acheng21567/RISCV-CPU-with-Image-Coproc-FPGA/RTL/coproc/VGA_test/Miku.bmp

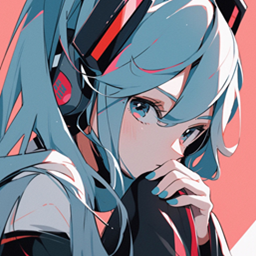
RTL/coproc/VGA_test/Miku.bmp
