acheng21567/RISCV-CPU-with-Image-Coproc-FPGA/Design_Diagrams/output_images/Contrast_Color_vs_Color.png

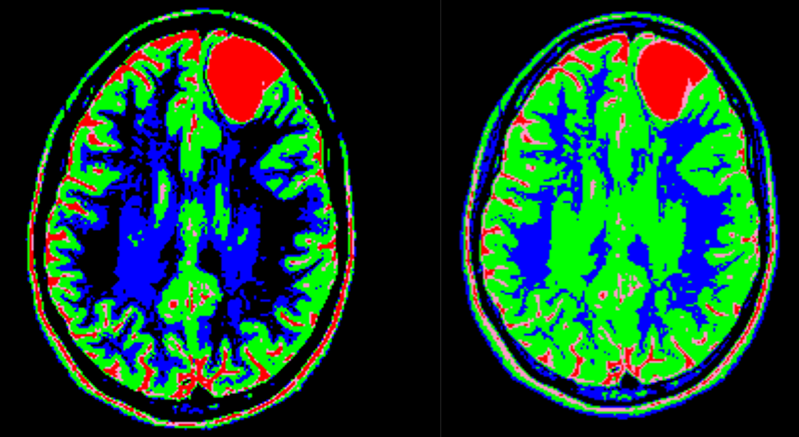
Design_Diagrams/output_images/Contrast_Color_vs_Color.png
