acheng21567/RISCV-CPU-with-Image-Coproc-FPGA/Design_Diagrams/Synthesis/top.pdf

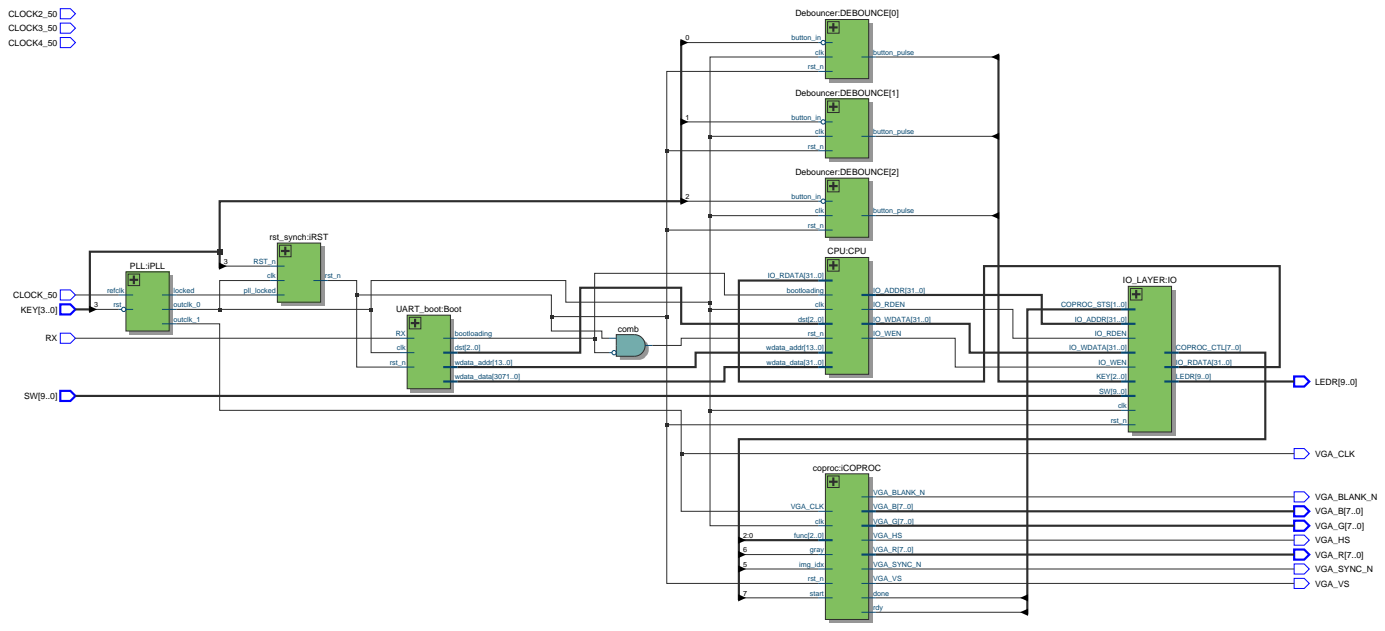
[picture p37: figure]
CLOCK_50 KEY[3..0]; PLL:iPLL; refclk; rst; locked; outclk_0; outclk_1; rst_synch:iRST; RST_n; clk; pll_locked; rst_n; UART_boot:Boot; bootloading; wdata_data[3071..0]; wdata_addr[13..0]; dst[2..0]; comb; Debouncer:DEBOUNCE[0]; button_in; button_pulse; Debouncer:DEBOUNCE[1]; Debouncer:DEBOUNCE[2]; CPU:CPU; IO_RDATA[31..0]; wdata_data[31..0]; IO_RDEN; IO_WEN; IO_WDATA[31..0]; IO_ADDR[31..0]; coproc:iCOPROC; VGA_CLK; gray; img_idx; start; func[2..0]; VGA_BLANK_N; VGA_HS; VGA_SYNC_N; VGA_VS; done; rdy; VGA_B[7..0]; VGA_G[7..0]; VGA_R[7..0]; IO_LAYER:IO; KEY[2..0]; COPROC_STS[1..0]; LEDR[9..0]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
