acheng21567/RISCV-CPU-with-Image-Coproc-FPGA/Bootload/pikachu.bmp

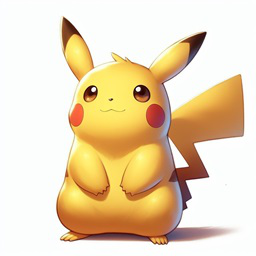
Bootload/pikachu.bmp
