acheng21567/RISCV-CPU-with-Image-Coproc-FPGA/COPROC/python/brain.bmp

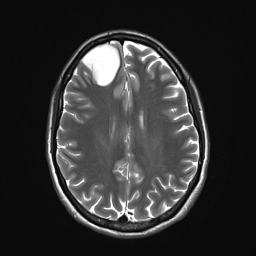
COPROC/python/brain.bmp
