acheng21567/RISCV-CPU-with-Image-Coproc-FPGA/COPROC/python/output_image.png

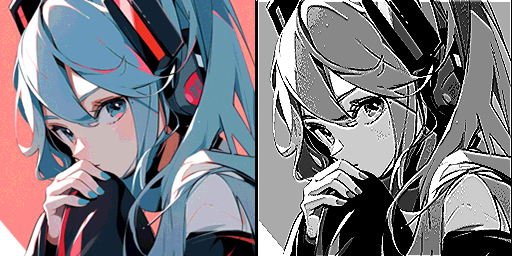
COPROC/python/output_image.png
