acheng21567/RISCV-CPU-with-Image-Coproc-FPGA/DEMO/Bootload/images/bunny.png

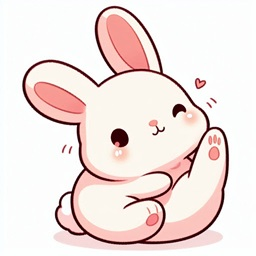
DEMO/Bootload/images/bunny.png
