acheng21567/RISCV-CPU-with-Image-Coproc-FPGA/Design_Diagrams/another_output_images/output_image_contrast.png

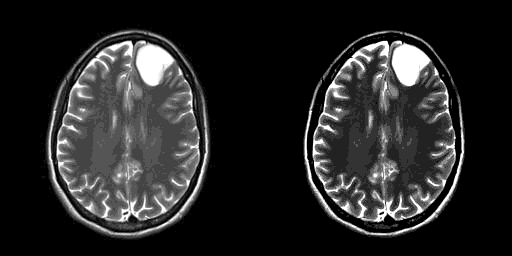
Design_Diagrams/another_output_images/output_image_contrast.png
