acheng21567/RISCV-CPU-with-Image-Coproc-FPGA/Design_Diagrams/Bootload.png

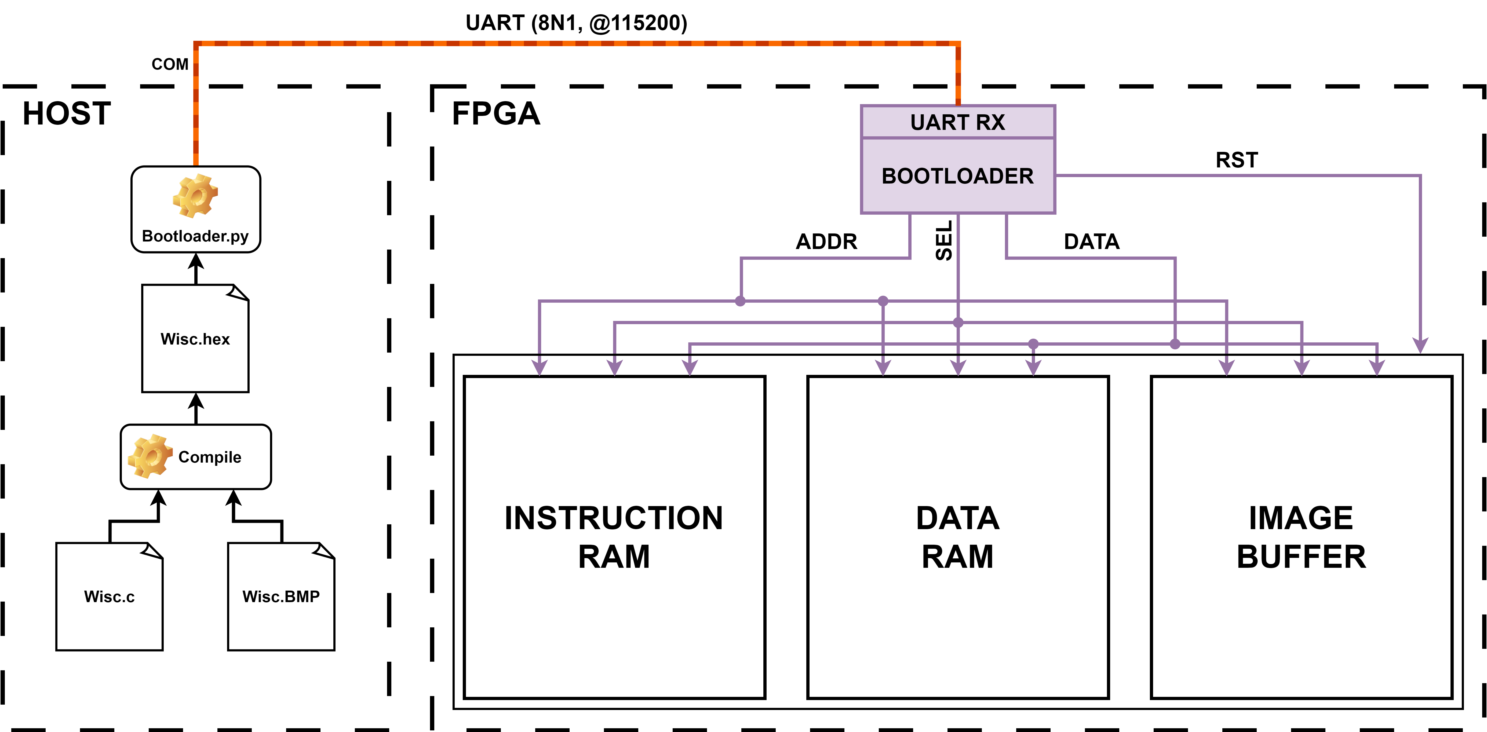
Design_Diagrams/Bootload.png
