acheng21567/RISCV-CPU-with-Image-Coproc-FPGA/Design_Diagrams/bootload_top-Copy of Page-1.png

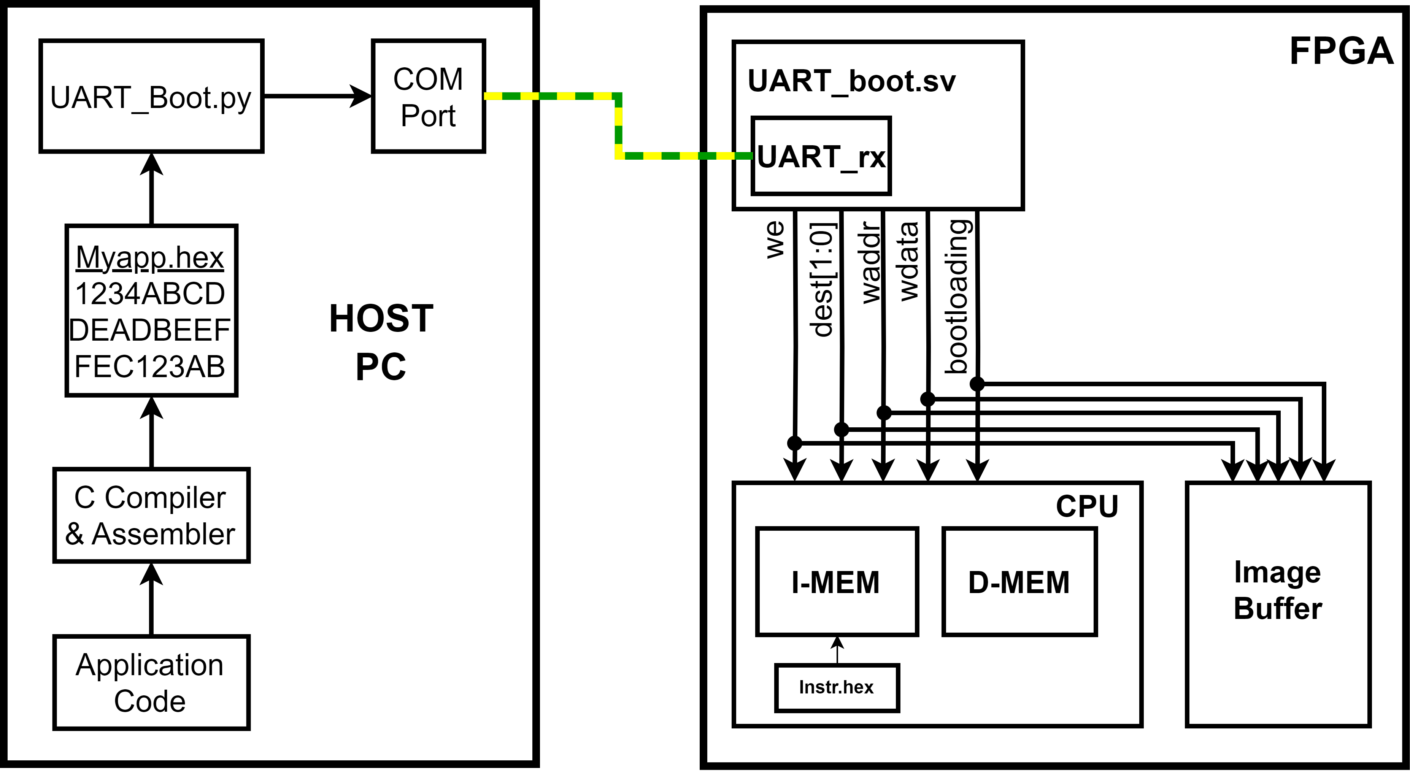
Design_Diagrams/bootload_top-Copy of Page-1.png
