acheng21567/RISCV-CPU-with-Image-Coproc-FPGA/Design_Diagrams/COPROC-FUNC.png

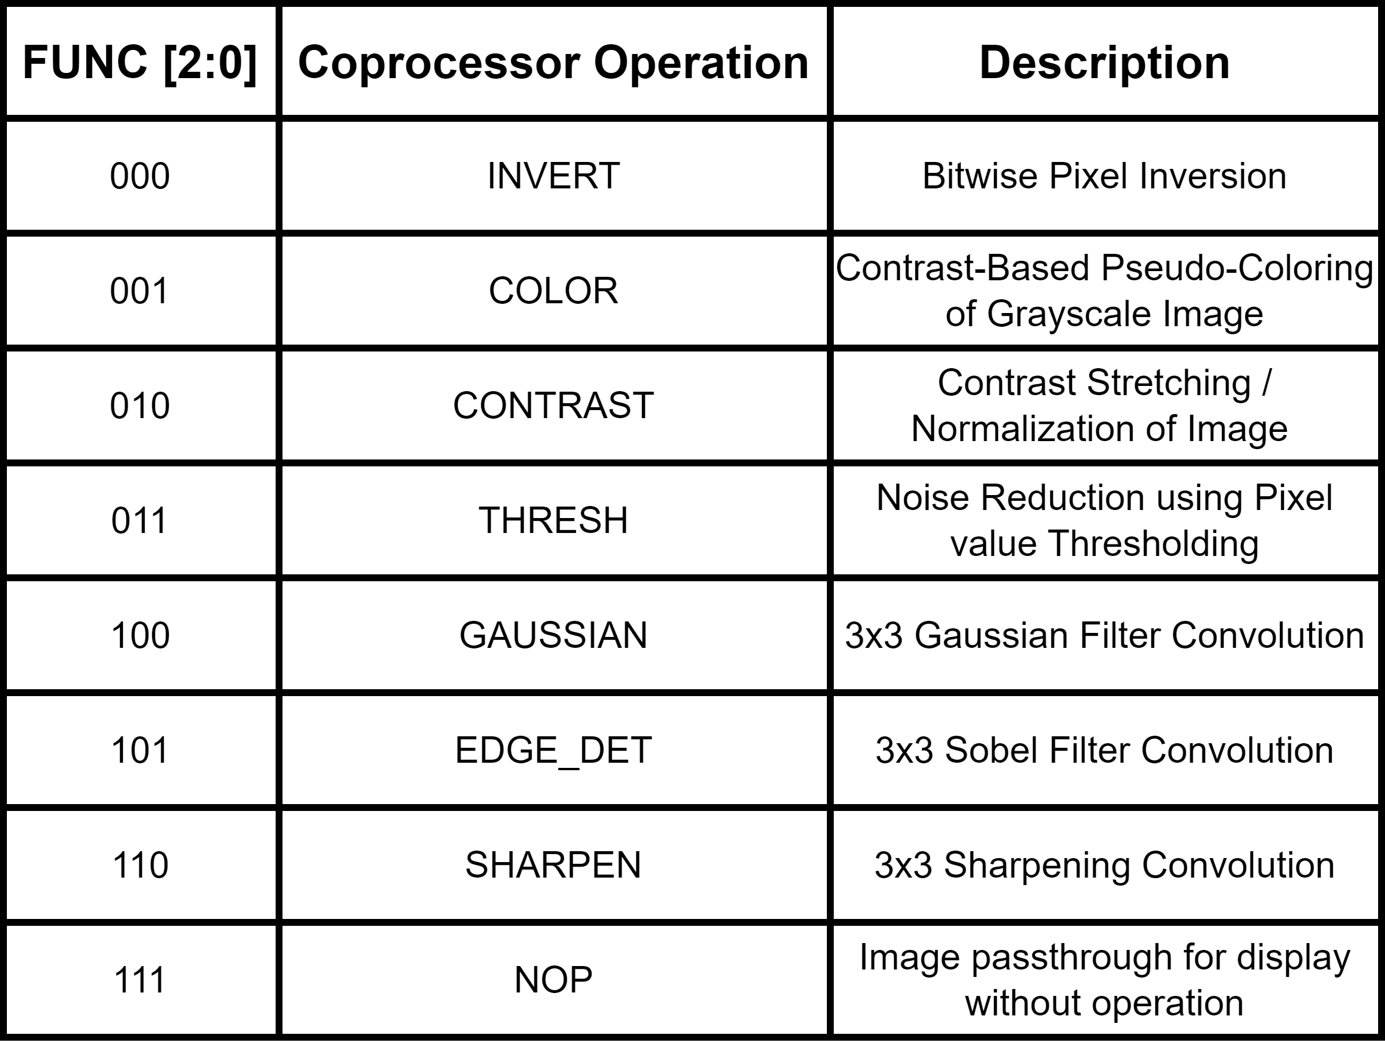
Design_Diagrams/COPROC-FUNC.png
