acheng21567/RISCV-CPU-with-Image-Coproc-FPGA/Design_Diagrams/DESIGN_DIAGRAMS-BOOTLOADER.png

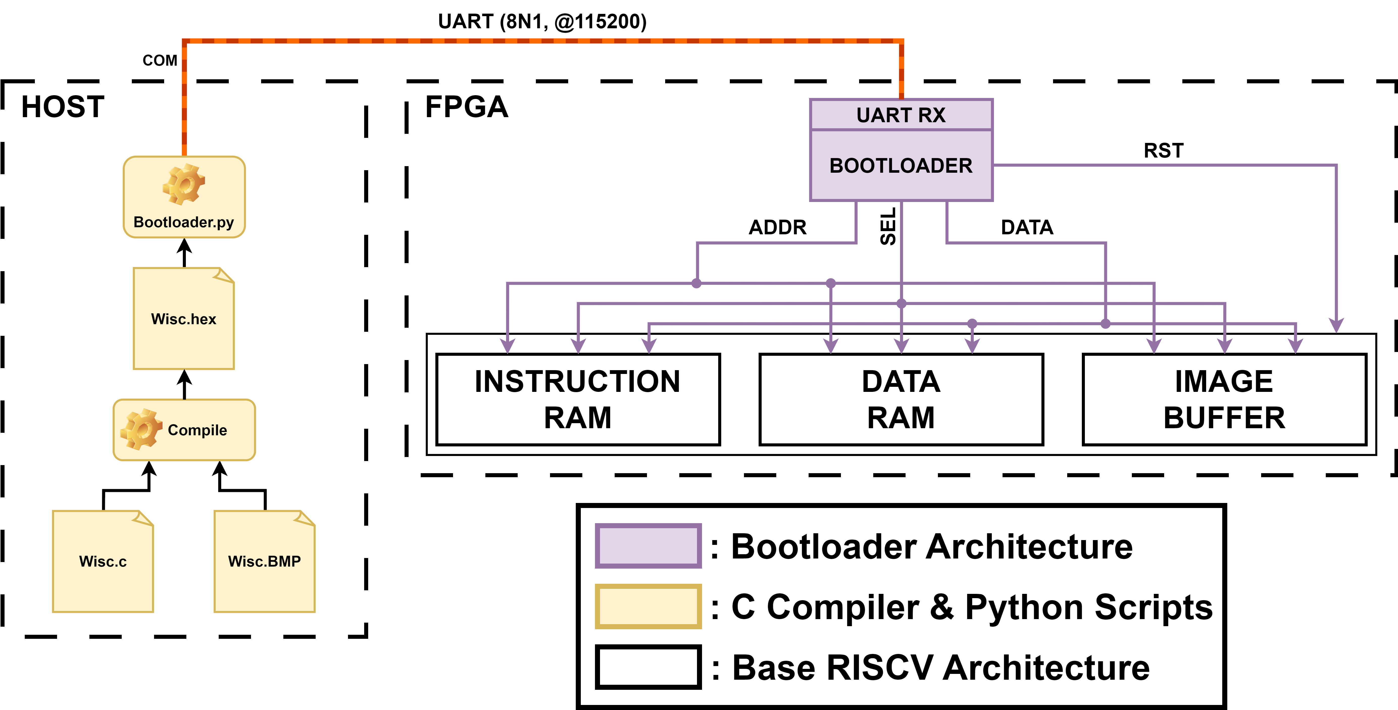
Design_Diagrams/DESIGN_DIAGRAMS-BOOTLOADER.png
