acheng21567/RISCV-CPU-with-Image-Coproc-FPGA/Design_Diagrams/DESIGN_DIAGRAMS-IO_LAYER.png

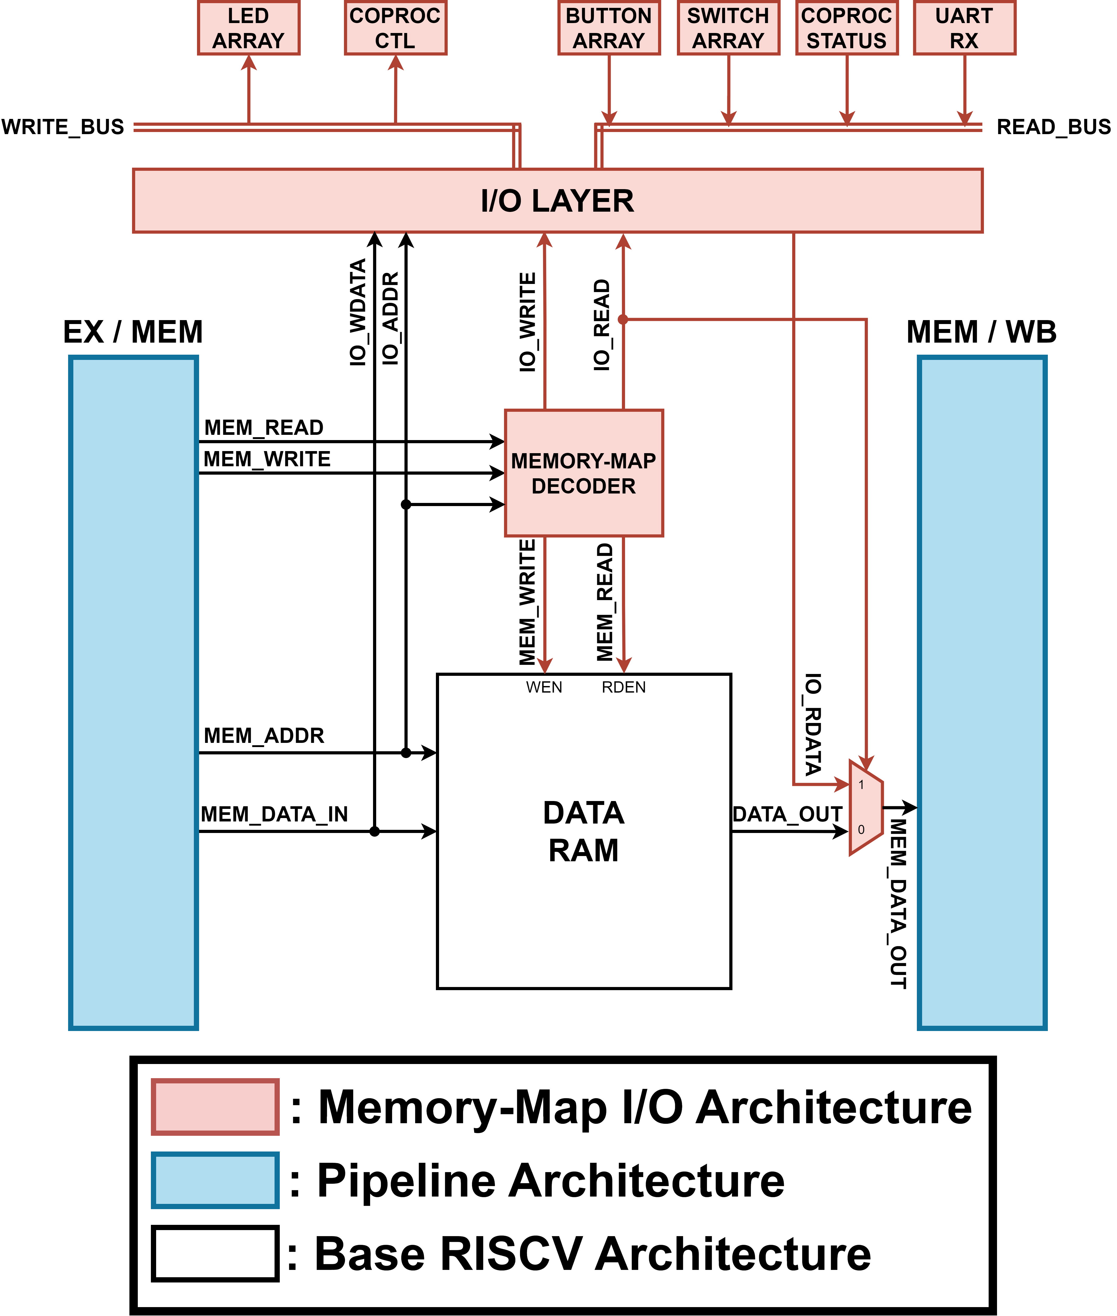
Design_Diagrams/DESIGN_DIAGRAMS-IO_LAYER.png
