acheng21567/RISCV-CPU-with-Image-Coproc-FPGA/Design_Diagrams/DESIGN_DIAGRAMS-Page-18.png

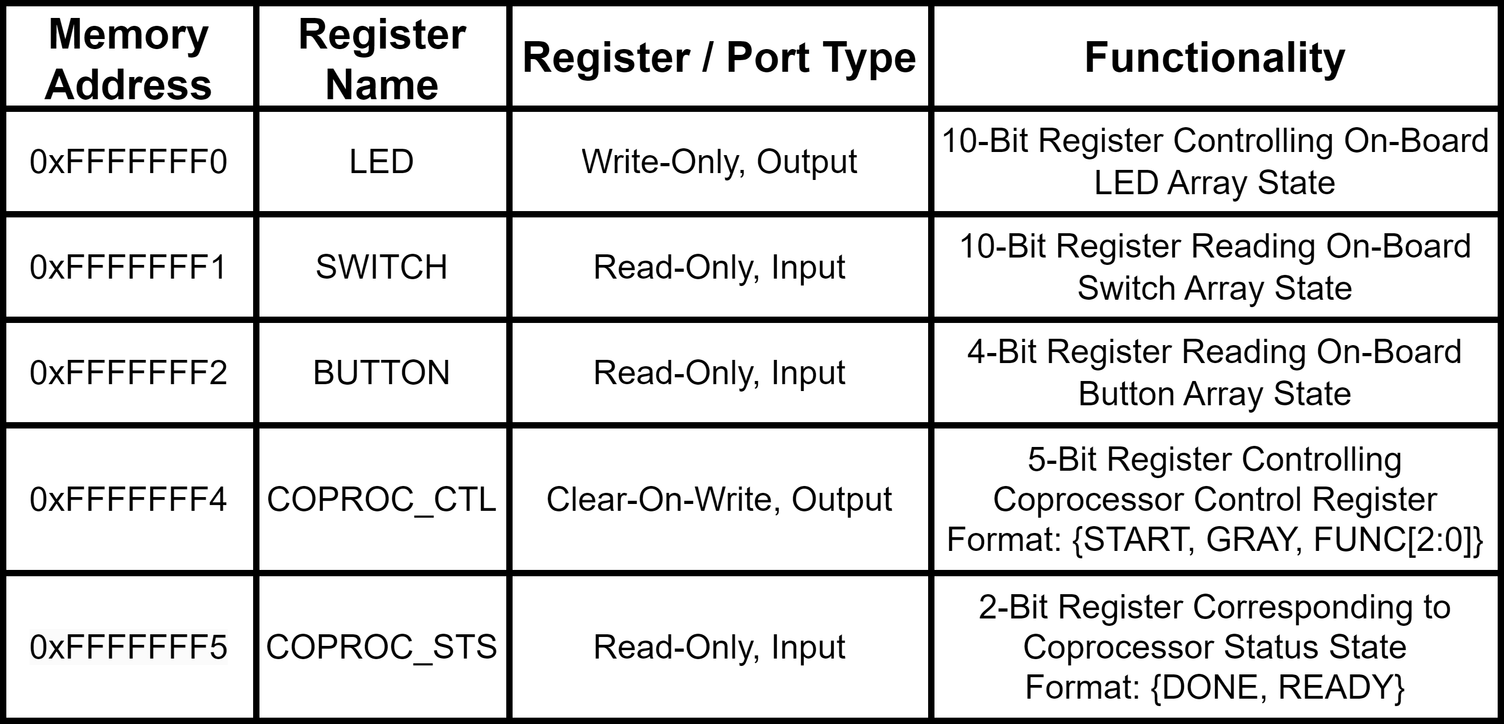
Design_Diagrams/DESIGN_DIAGRAMS-Page-18.png
