acheng21567/RISCV-CPU-with-Image-Coproc-FPGA/Design_Diagrams/DESIGN_DIAGRAMS-Page-23.drawio.png

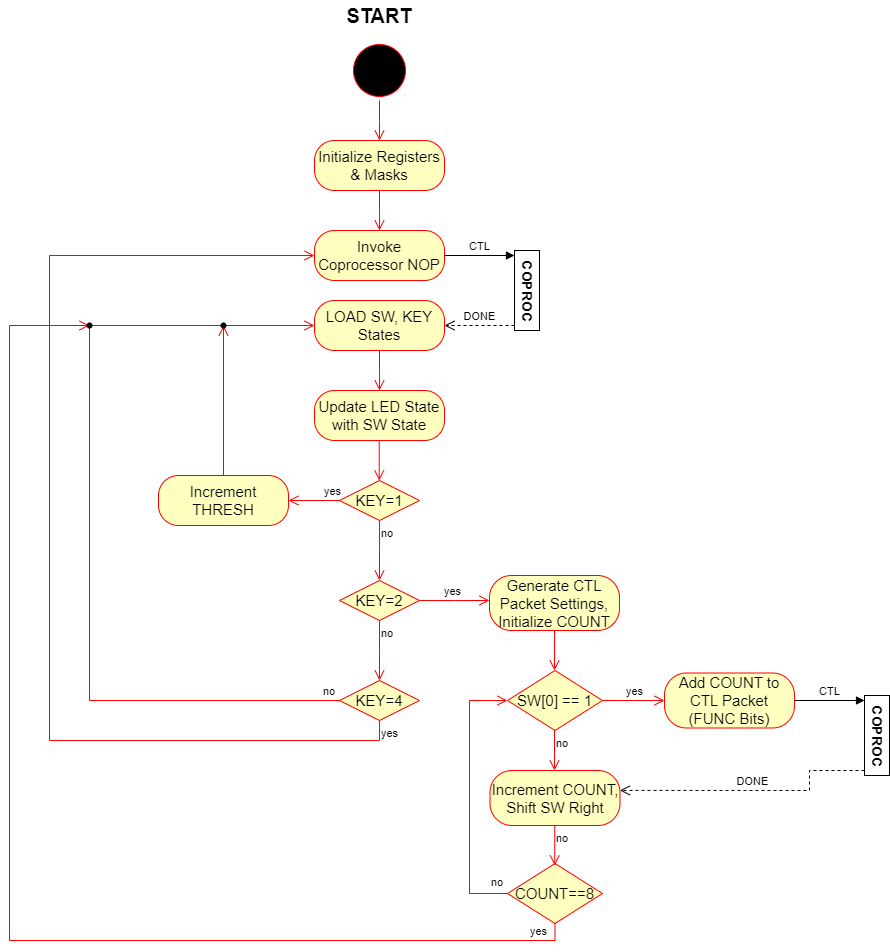
Design_Diagrams/DESIGN_DIAGRAMS-Page-23.drawio.png
