acheng21567/RISCV-CPU-with-Image-Coproc-FPGA/Design_Diagrams/DESIGN_DIAGRAMS-SINGLE_CYCLE_TOP.png

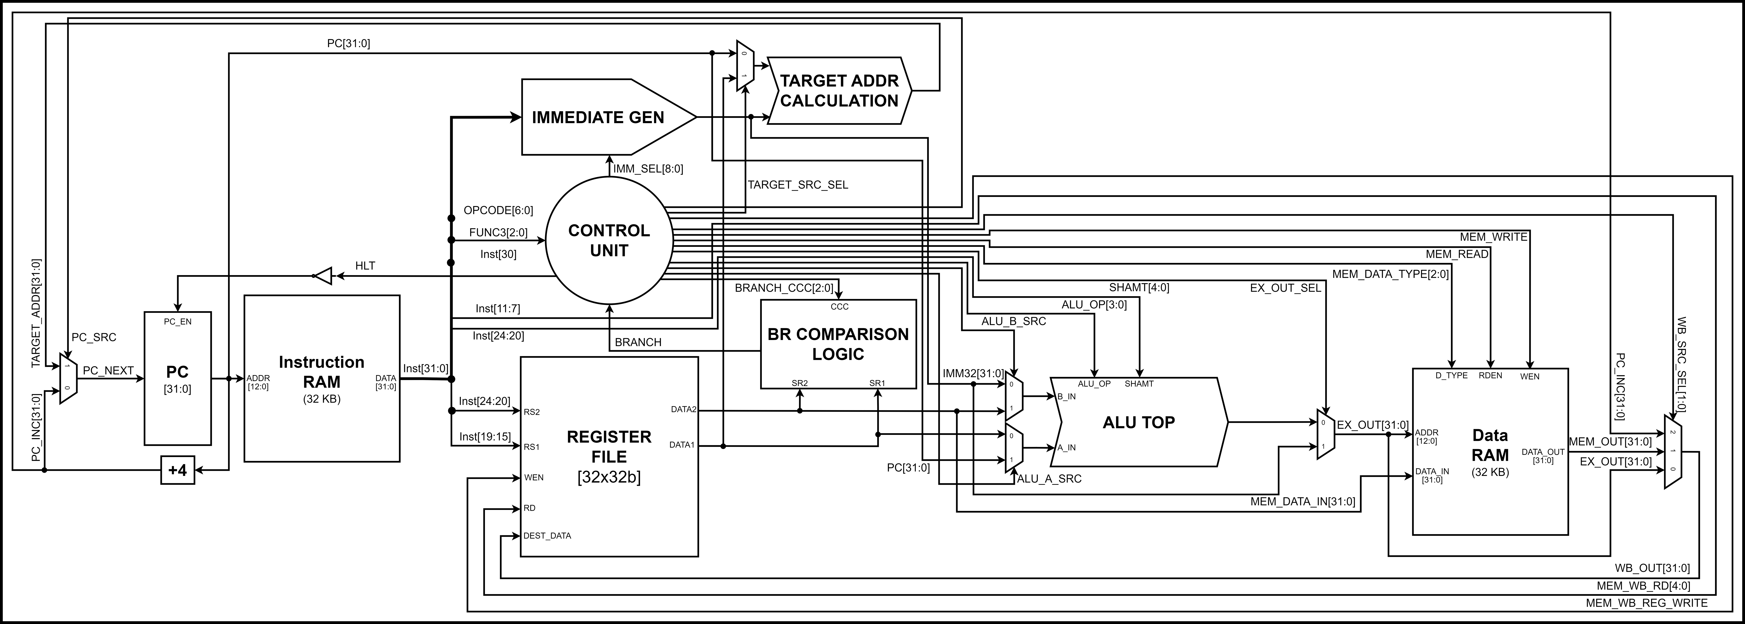
Design_Diagrams/DESIGN_DIAGRAMS-SINGLE_CYCLE_TOP.png
