acheng21567/RISCV-CPU-with-Image-Coproc-FPGA/Design_Diagrams/DESIGN_DIAGRAMS-TOP-LEVEL2.png

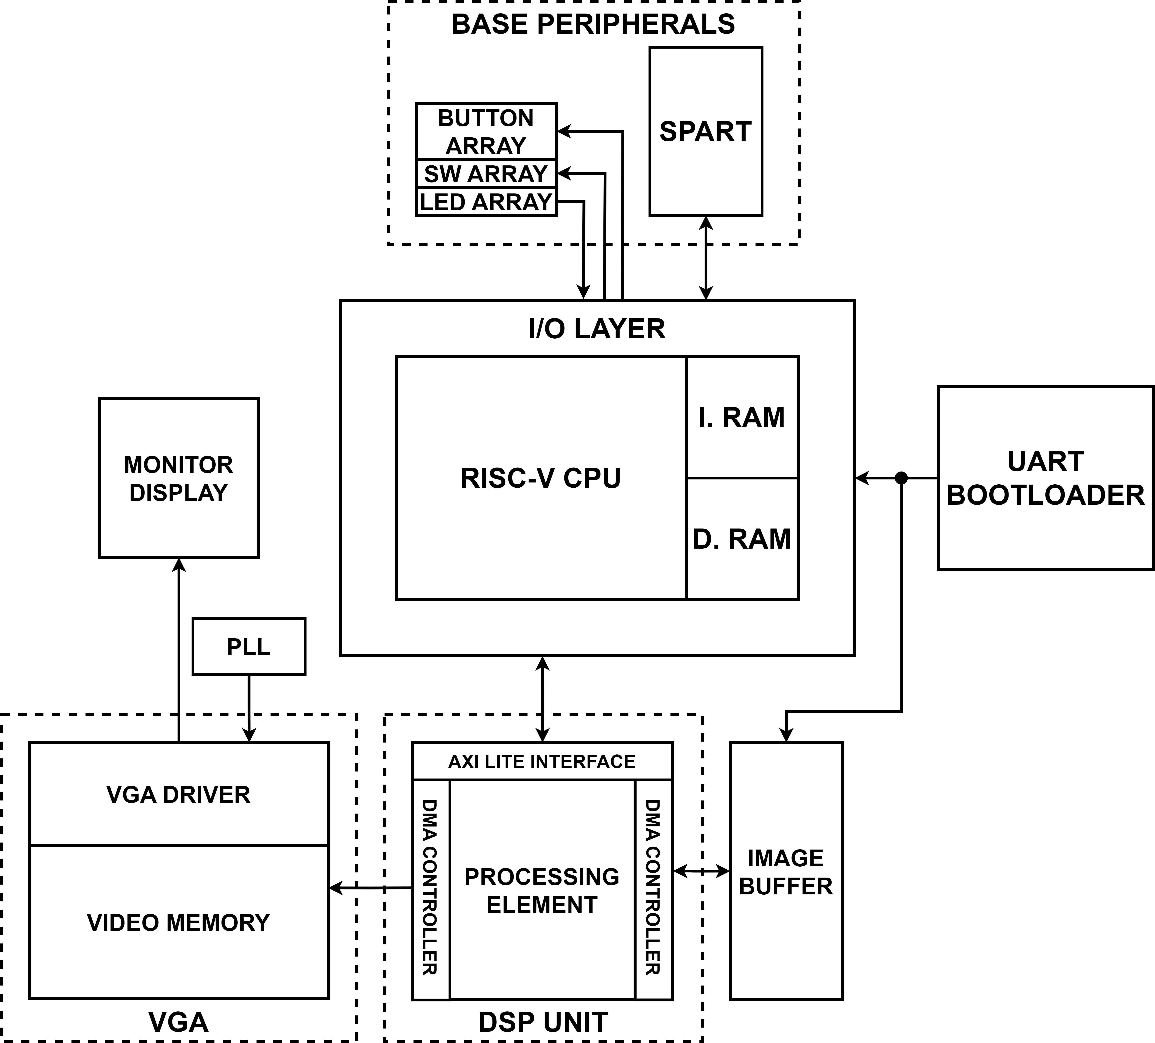
Design_Diagrams/DESIGN_DIAGRAMS-TOP-LEVEL2.png
