acheng21567/RISCV-CPU-with-Image-Coproc-FPGA/Design_Diagrams/ImageBuffer-Caching.png

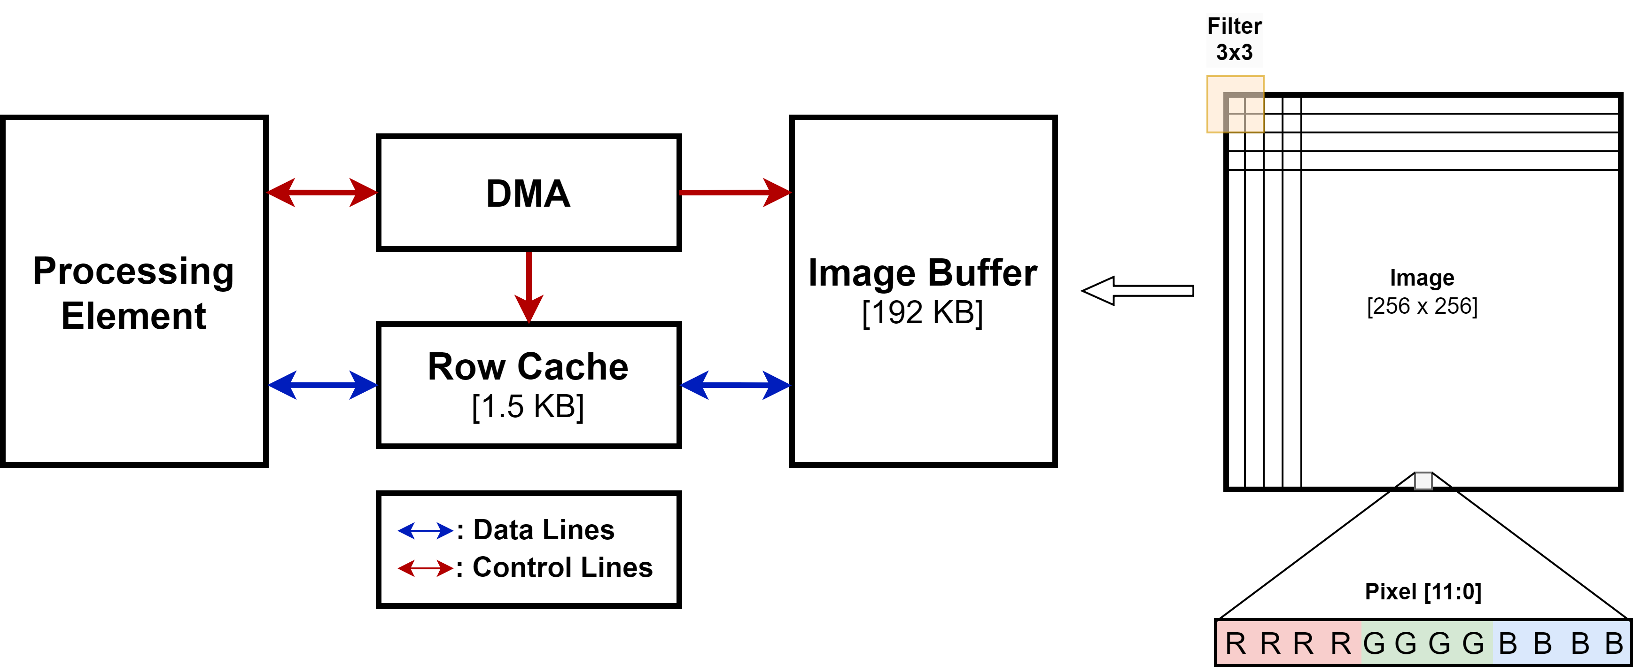
Design_Diagrams/ImageBuffer-Caching.png
