acheng21567/RISCV-CPU-with-Image-Coproc-FPGA/Design_Diagrams/ImageBuffer-Storage_Format.png

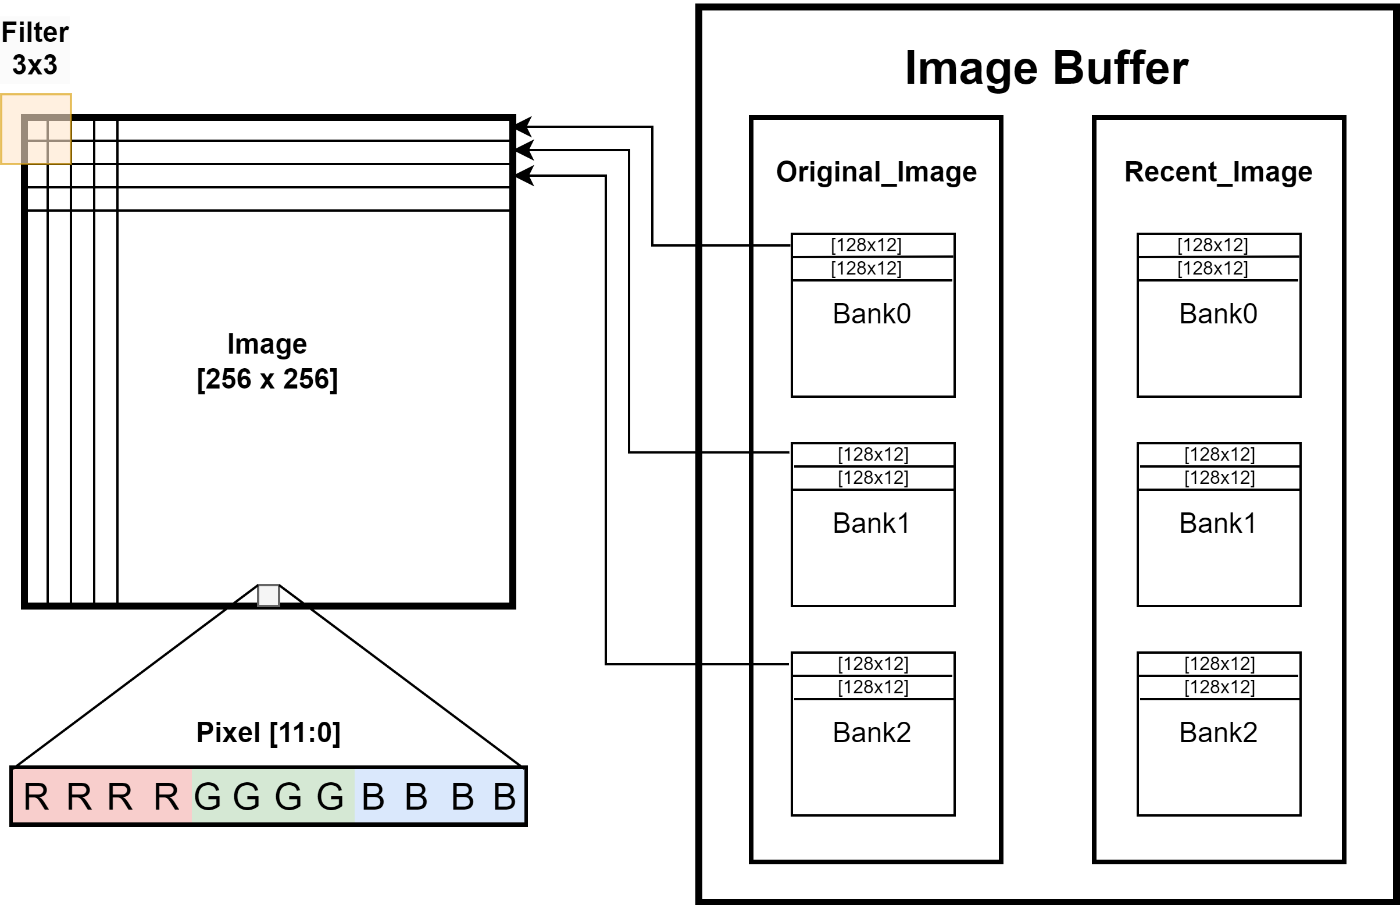
Design_Diagrams/ImageBuffer-Storage_Format.png
