acheng21567/RISCV-CPU-with-Image-Coproc-FPGA/Design_Diagrams/output_images/output_image_edge.png

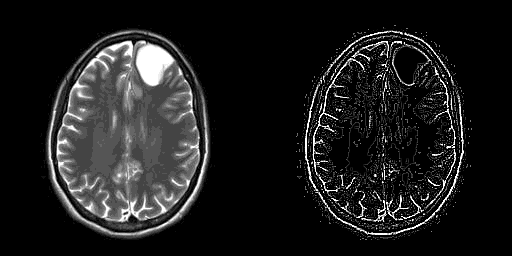
Design_Diagrams/output_images/output_image_edge.png
