acheng21567/RISCV-CPU-with-Image-Coproc-FPGA/Design_Diagrams/Synthesis/1.png

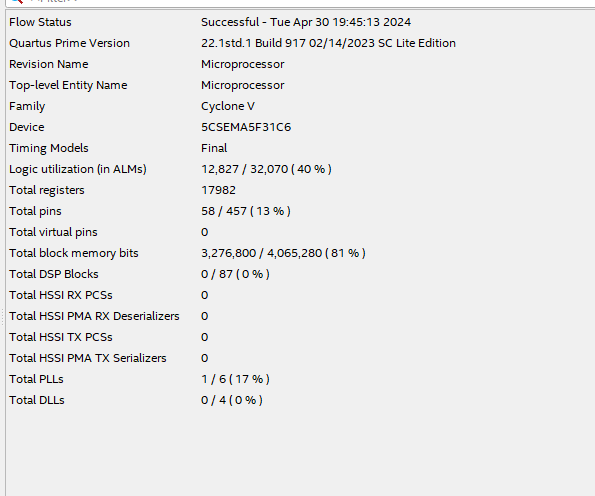
Design_Diagrams/Synthesis/1.png
