acheng21567/RISCV-CPU-with-Image-Coproc-FPGA/Design_Diagrams/Synthesis/utilization.png

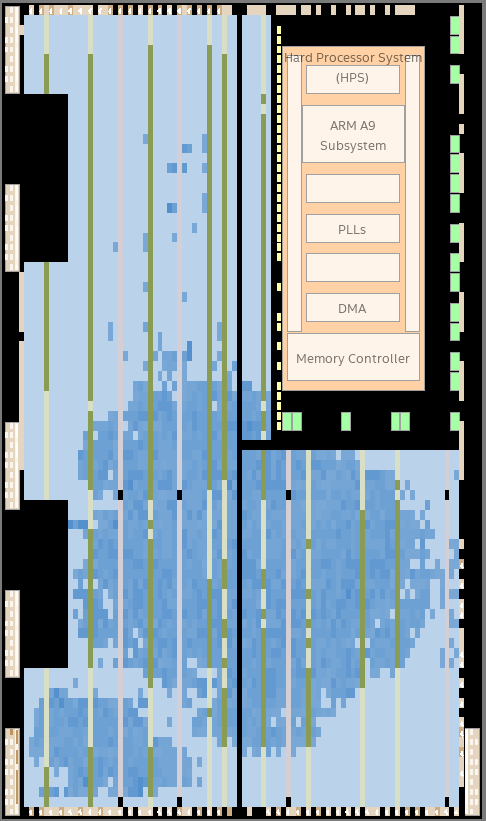
Design_Diagrams/Synthesis/utilization.png
