acheng21567/RISCV-CPU-with-Image-Coproc-FPGA/Design_Diagrams/TOP.png

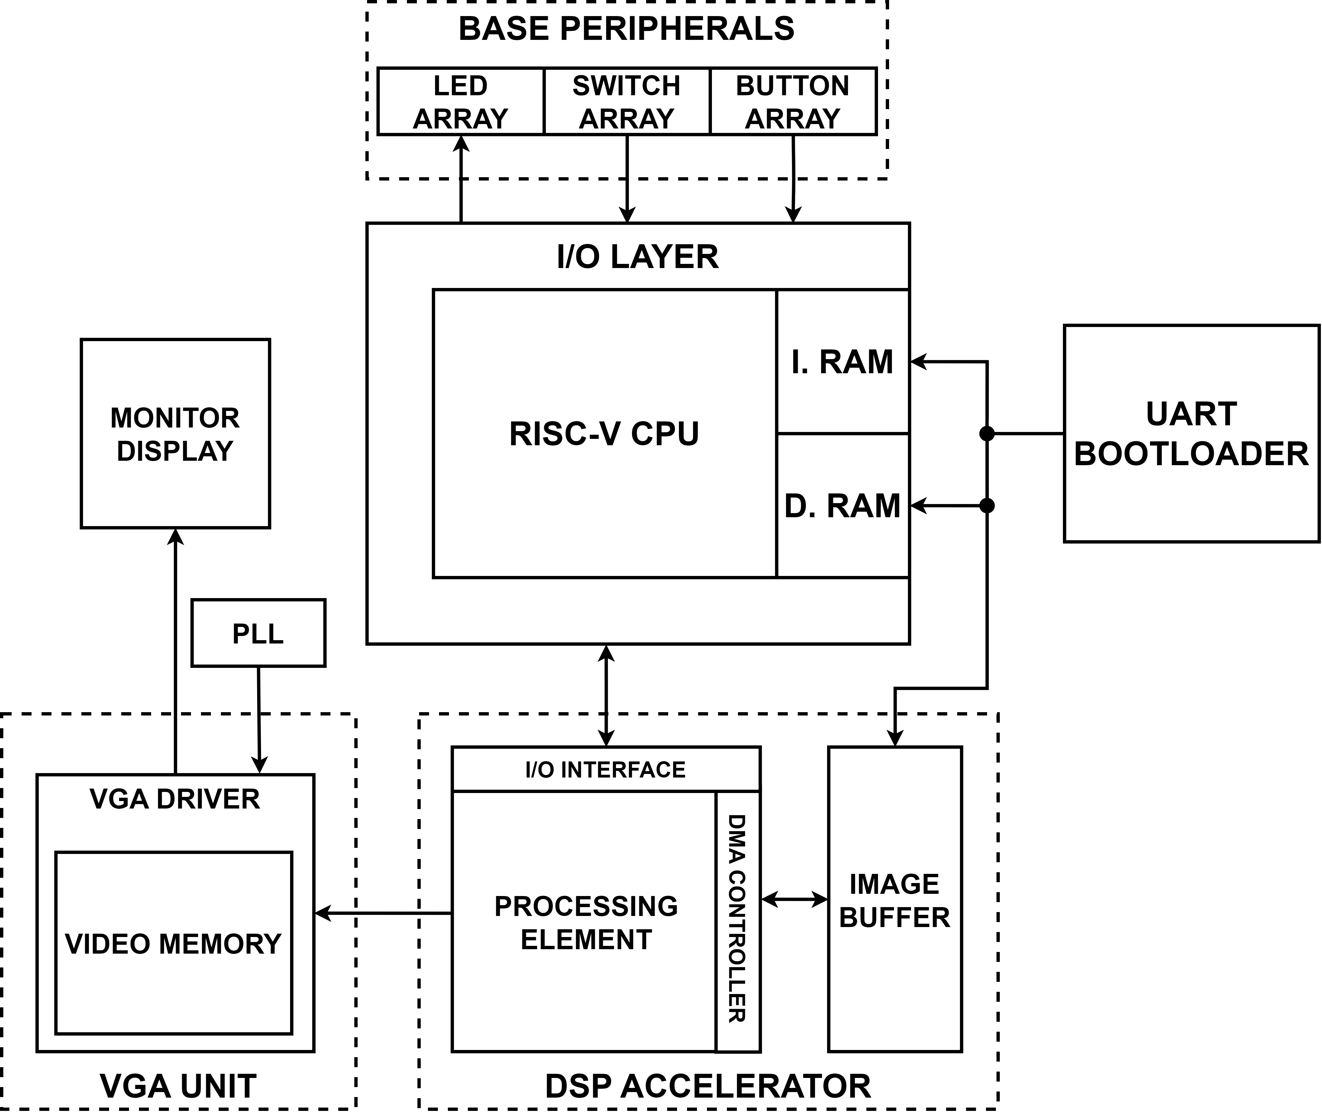
Design_Diagrams/TOP.png
