acheng21567/RISCV-CPU-with-Image-Coproc-FPGA/Design_Diagrams/UART Protocol.png

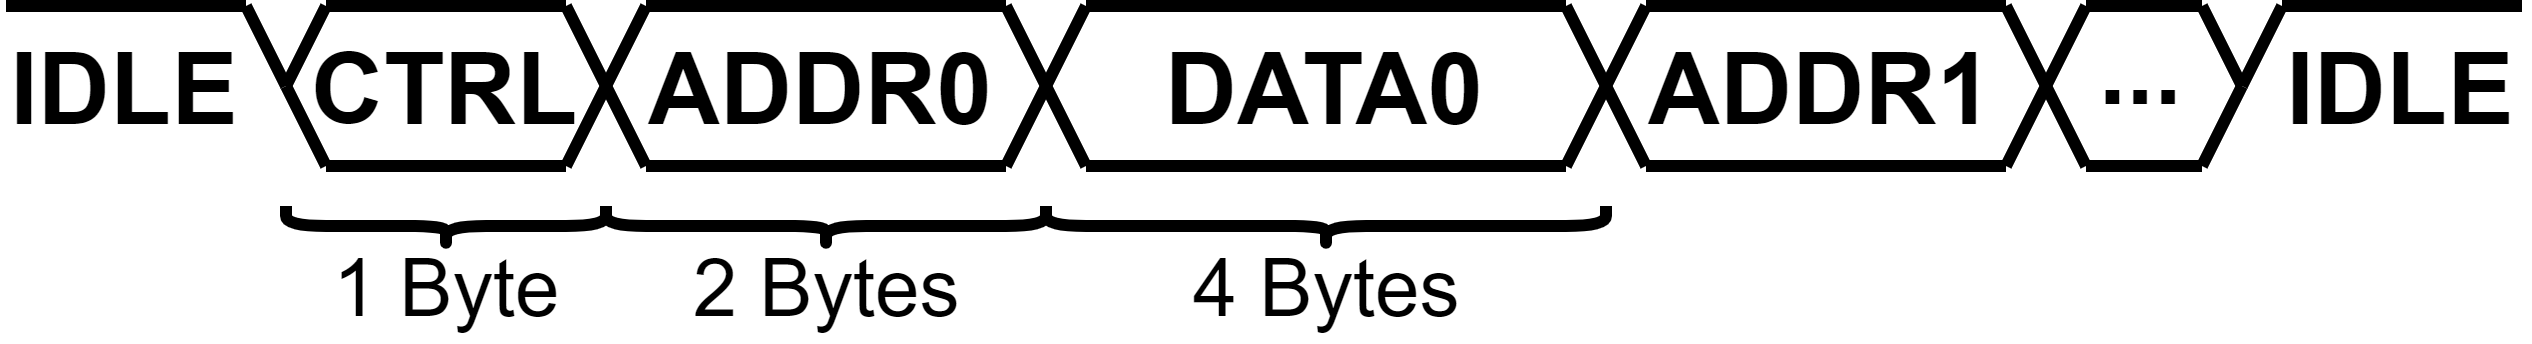
Design_Diagrams/UART Protocol.png
