acheng21567/RISCV-CPU-with-Image-Coproc-FPGA/RTL/coproc/output_image.png

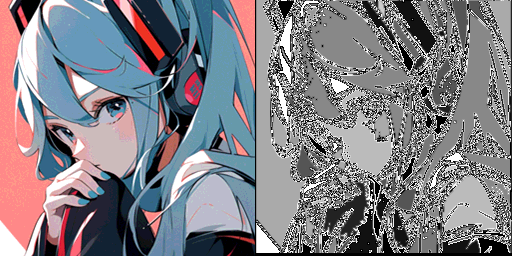
RTL/coproc/output_image.png
