acheng21567/RISCV-CPU-with-Image-Coproc-FPGA/RTL/coproc/output_image_gray_coloring.png

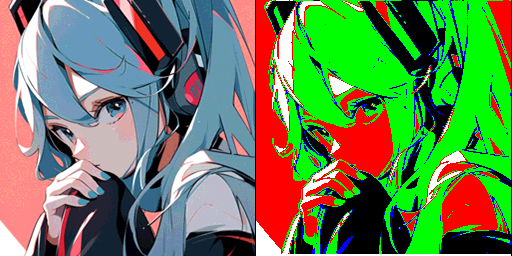
RTL/coproc/output_image_gray_coloring.png
