acheng21567/RISCV-CPU-with-Image-Coproc-FPGA/RTL/coproc/output_image_invert.png

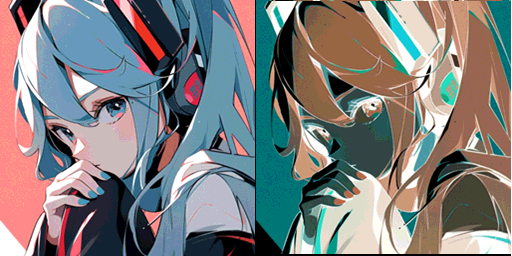
RTL/coproc/output_image_invert.png
