acheng21567/RISCV-CPU-with-Image-Coproc-FPGA/ALU_OPERATIONS.xlsx

Instruction | Operation | Type | Opcode | FUNC3 | BIT30 | Operation | ALUOP
AUIPC | ADDER | U | 0010111 |  |  | ADD | 0000
LOAD | ADDER | I | 0000011 |  |  | SUB | 0010
STORE | ADDER | S | 0100011 |  |  | SLT | 0011
ADDI | ADDER | I | 0010011 | 000 |  | SLTU | 1011
SLTI | SLT | I | 0010011 | 010 |  | XOR | 0100
SLTIU | SLTU | I | 0010011 | 011 |  | OR | 0101
XORI | XOR | I | 0010011 | 100 |  | AND | 0110
ORI | OR | I | 0010011 | 110 |  | SLL | 1100
ANDI | AND | I | 0010011 | 111 |  | SRL | 1101
SLLI | SLL | I | 0010011 | 001 |  | SRA | 1111
SRLI | SRL | I | 0010011 | 101 | 0
SRAI | SRA | I | 0010011 | 101 | 1 |  |  | Control
ADD | ADDER | R | 0110011 | 000 | 0 |  |  | (~[2])([1][0]) | Comparator Out
SUB | ADDER | R | 0110011 | 000 | 1 |  |  | [3] | Comparator Sel
SLL | SLL | R | 0110011 | 001 |  |  |  | ~([3]|[2]|[0]) | Adder Out
SLT | SLT | R | 0110011 | 010 |  |  |  | (~[3])([2]) | Logic Out
SLTU | SLTU | R | 0110011 | 011 |  |  |  | [3][2] | Shifter Out
XOR | XOR | R | 0110011 | 100 |  |  |  | [1] | SUB / Cin
SRL | SRL | R | 0110011 | 101 | 0 |  |  | [1:0] | L.U Sel
SRA | SRA | R | 0110011 | 101 | 1 |  |  | [1:0] | Shift Sel
OR | OR | R | 0110011 | 110 |  |  |  | [3,1:0] | Adder Sel
AND | AND | R | 0110011 | 111
