acheng21567/RISCV-CPU-with-Image-Coproc-FPGA/Results.xlsx

 | CPU Only |  | CPU + COPROC |  |  |  | CPU + COPROC + LWCP
Operation | Cycle Count | Instruction Count | Cycle Count | Instruction Count | Cycle Improvement(X) | Instruction Improvement(X) | Cycle Count | Instruction Count | Cycle Improvement (X) | Instruction Improvement(X)
Inversion | 2297890 | 1838366 | 65551 | 43700 | 35.05499535 | 52.58329519 | 65543 | 5 | 35.05927406 | 367673.2
Thresh | 2494498 | 2034974 | 65551 | 43700 | 38.05430886 | 57.0823341 | 65543 | 5 | 38.05895366 | 406994.8
Color | 6492194 | 5311774 | 65551 | 43700 | 99.04035026 | 148.5627918 | 65543 | 5 | 99.05243886 | 1062354.8
Conv | 51165312 | 43422626 | 65551 | 43700 | 780.5420512 | 1170.830938 | 65543 | 5 | 780.6373221 | 8684525.2
Contrast | 7606319 | 6819114 | 65551 | 43700 | 116.0366585 | 174.057643 | 65543 | 5 | 116.0508216 | 1363822.8
NOP | 4395052 | 3476776 | 65551 | 43700 | 67.04782536 | 100.5732723 | 65543 | 5 | 67.05600903 | 695355.2
 |  |  |  | Operation | Speedup
 |  |  |  | NOP | 67
 |  |  |  | Inversion | 35
 |  |  |  | Thresh | 38
 |  |  |  | Color | 99
 |  |  |  | Contrast | 116
 |  |  |  | Convolution | 780
