acheng21567/RISCV-CPU-with-Image-Coproc-FPGA/Design_Diagrams/Synthesis/coproc_top.pdf

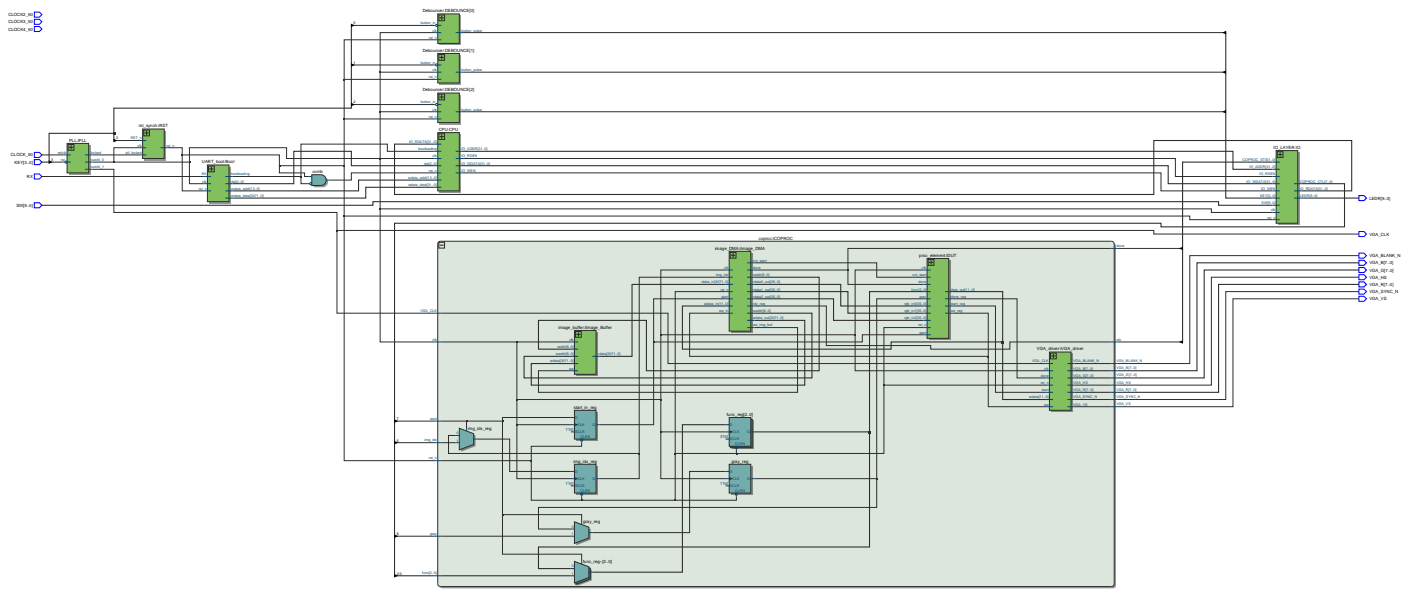
[picture p70: page 1]
coproc:iCOPROC; VGA_CLK; clk; gray; img_idx; rst_n; start; func[2..0]; VGA_BLANK_N; VGA_HS; VGA_SYNC_N; VGA_VS; done; rdy; VGA_B[7..0] VGA_G[7..0]; VGA_R[7..0]; CLOCK2_50 CLOCK3_50 CLOCK4_50; CPU:CPU; bootloading; IO_RDATA[31..0]; wdata_data[31..0] wdata_addr[13..0]; IO_RDEN; IO_WEN; IO_WDATA[31..0]; IO_ADDR[31..0]; Debouncer:DEBOUNCE[0]; button_in; button_pulse; Debouncer:DEBOUNCE[1]; Debouncer:DEBOUNCE[2]; IO_LAYER:IO; SW[9..0] KEY[2..0]; COPROC_STS[1..0]; LEDR[9..0]; COPROC_CTL[7..0]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

dst[2..0]

raddr[8..0] waddr[8..0] wdata[3071..0]
