acheng21567/RISCV-CPU-with-Image-Coproc-FPGA/Design_Diagrams/Synthesis/proc_element.pdf

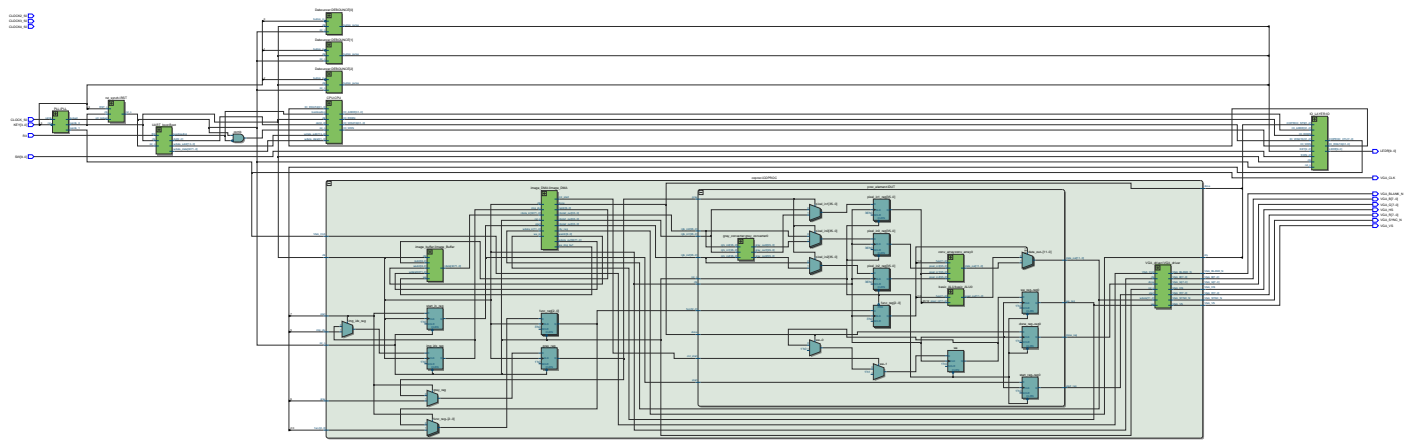
[picture p71: page 1]
coproc:iCOPROC; clk; gray; img_idx; rst_n; start; func[2..0]; VGA_BLANK_N; VGA_HS; VGA_SYNC_N; VGA_VS; done; rdy; VGA_B[7..0] VGA_G[7..0] VGA_R[7..0]; cnt_start; done_reg; start_reg; we_reg; data_out[11..0]; CLOCK3_50 CLOCK4_50; CPU:CPU; bootloading; IO_RDATA[31..0]; wdata_data[31..0] wdata_addr[13..0]; dst[2..0]; IO_RDEN; IO_WEN; IO_WDATA[31..0]; IO_ADDR[31..0]; Debouncer:DEBOUNCE[0] button_in; button_pulse Debouncer:DEBOUNCE[1] button_in; button_pulse Debouncer:DEBOUNCE[2] button_in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

VGA_CLK | image_DMA:iImage_DMA | proc_element:iDUT

pixel_in1[35..0] 01 | pixel_in1_reg[35..0] D SCLR 36'h0 CLKCLRN Q

rgb_in0[35..0] rgb_in1[35..0] rgb_in2[35..0] rst_n

raddr[8..0] waddr[8..0] wdata[3071..0]

start we wdata[11..0]
