acheng21567/RISCV-CPU-with-Image-Coproc-FPGA/Design_Diagrams/Synthesis/vga_top.pdf

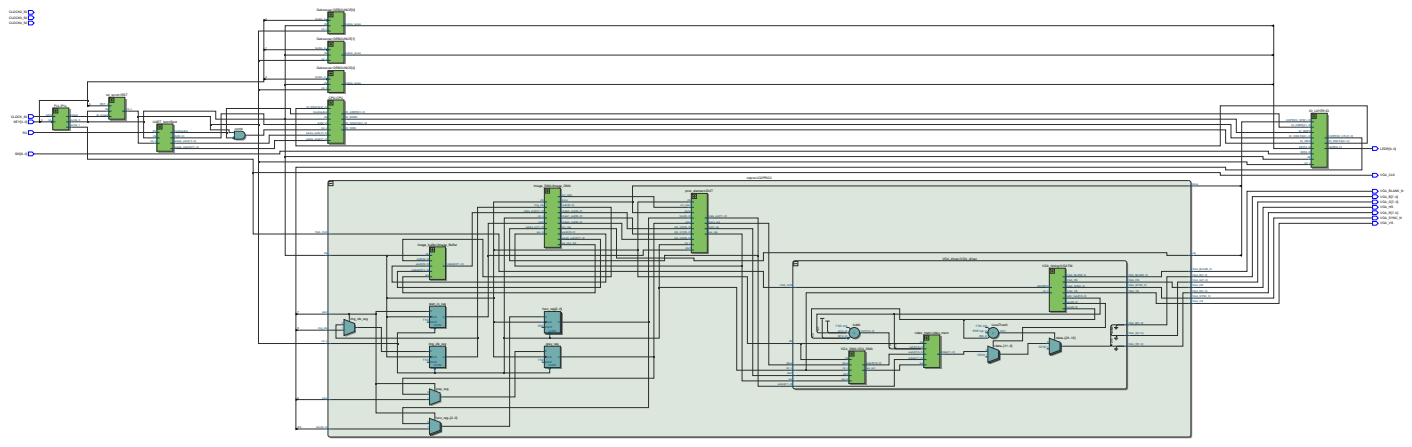
[picture p72: page 1]
coproc:iCOPROC; VGA_CLK; clk; gray; img_idx; rst_n; start; func[2..0]; VGA_BLANK_N; VGA_HS; VGA_SYNC_N; VGA_VS; done; rdy; VGA_B[7..0] VGA_G[7..0] VGA_R[7..0]; VGA_driver:iVGA_driver; VGA_R[7..0]; VGA_G[7..0]; VGA_B[7..0]; CLOCK3_50 CLOCK4_50; CPU:CPU; bootloading; IO_RDATA[31..0]; wdata_data[31..0] wdata_addr[13..0]; dst[2..0]; IO_RDEN; IO_WEN; IO_WDATA[31..0]; IO_ADDR[31..0]; Debouncer:DEBOUNCE[0] button_in; button_pulse Debouncer:DEBOUNCE[1] button_in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

raddr[8..0] waddr[8..0] wdata[3071..0]

start we wdata[11..0]
