acheng21567/RISCV-CPU-with-Image-Coproc-FPGA/Design_Diagrams/Synthesis/hazard_top.pdf

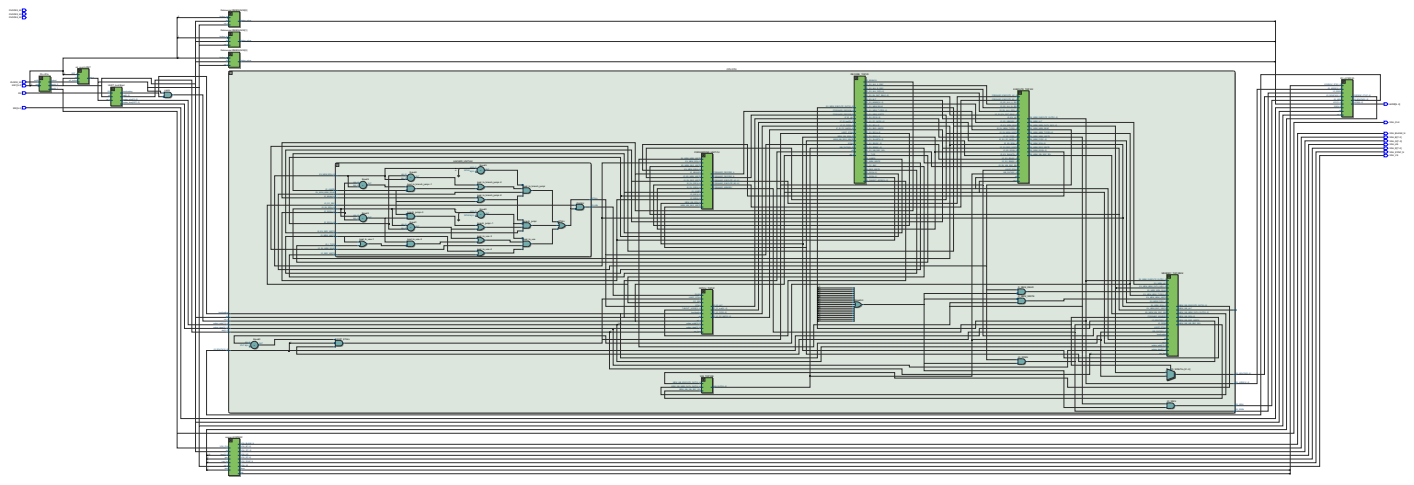
[picture p73: page 1]
CPU:CPU; bootloading clk rst_n; IO_RDATA[31..0]; wdata_data[31..0] wdata_addr[13..0] dst[2..0]; IO_RDEN; IO_WEN; IO_WDATA[31..0]; IO_ADDR[31..0]; EX_MEM_MEM_READ ID_BRANCH; ID_EX_MEM_READ; ID_EX_REG_WRITE; ID_I_TYPE; ID_JUMPR; ID_MEM_WRITE; ID_PC_SRC; ID_REG_WRITE; EX_MEM_RD[4..0]; FLUSH; STALL; CLOCK3_50 CLOCK4_50; rst_synch:iRST; RST_n clk pll_locked; rst_n; DECODE_TOP:ID; FORWARD_DECODE_A FORWARD_DECODE_B IF_ID_HLT; LWCP_STALL MEM_WB_REG_WRITE; clk; IF_ID_Inst[31..0] IF_ID_PC[31..0]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

HAZARD_UNIT:HU | rst_n
