acheng21567/RISCV-CPU-with-Image-Coproc-FPGA/Design_Diagrams/Synthesis/alu_top.pdf

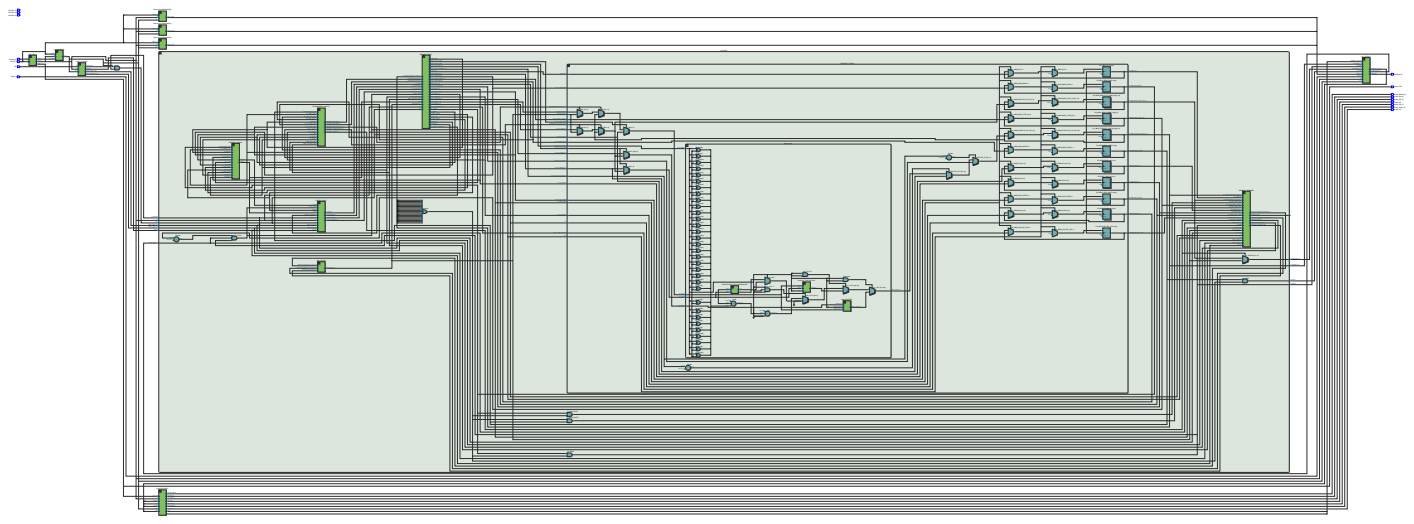
[picture p74: page 1]
CPU:CPU; bootloading; IO_RDATA[31..0]; wdata_data[31..0] wdata_addr[13..0] dst[2..0]; IO_RDEN; IO_WEN; IO_WDATA[31..0]; IO_ADDR[31..0]; EXECUTE_TOP:EX; ID_EX_HLT; ID_EX_MEM_READ; ID_EX_WB_SRC_SEL; clk; rst_n; FORWARD_EXECUTE_A[1..0]; EX_MEM_HLT; EX_MEM_MEM_READ; EX_MEM_MEM_WRITE; EX_MEM_REG_WRITE; EX_MEM_WB_SRC_SEL; EX_MEM_EXECUTE_OUT[31..0]; EX_MEM_MEM_DATA_IN[31..0]; EX_MEM_MEM_TYPE[2..0]; EX_MEM_RD[4..0]; EX_MEM_RS2[4..0]; EX_MEM_PC[31..0]; ALU:alu_top; ALU_OP[3..0]; SHAMT[4..0]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

ID_BRANCH ID_EX_ALU_A_SRC ID_EX_ALU_B_SRC ID_EX_EX_OUT_SEL[1..0] ID_EX_ALU_OP[3..0] EX_MEM_EXECUTE_OUT[31..0] ID_EX_HLT ID_EX_MEM_READ ID_EX_IMM32[31..0] FORWARD_DECODE_A FORWARD_DECODE_B IF_ID_HLT ID_EX_MEM_WRITE ID_EX_MEM_TYPE[2..0] ID_EX_PC[31..0] IF_ID_Inst[31..0] ID_EX_REG_WRITE ID_EX_RD[4..0] ID_EX_PC_INC[31..0] clk rst_n

EX_MEM_HLT~1 0 1'h0 1 EX_MEM_HLT~reg0 D SCLR 1'h0 Q EX_MEM_HLT~0 01 CLK

EX_MEM_MEM_READ~1 0 1'h0 1 EX_MEM_MEM_READ~reg0 D SCLR 1'h0 Q EX_MEM_MEM_READ~0 01 CLK

EX_MEM_MEM_DATA_IN~[63..32] 0 32'h0 1 EX_MEM_MEM_DATA_IN[0]~reg[31..0] D SCLR 32'h0 Q EX_MEM_MEM_DATA_IN~[31..0] 01 CLK

FORWARD_EXECUTE_B[1..0] WB_DATA[31..0] ID_EX_SRA[31..0] ID_EX_MEM_TYPE[2..0] ID_EX_ALU_A_SRC | | EX_MEM_MEM_TYPE~[5..3] 0 3'h0 1 EX_MEM_MEM_TYPE[0]~reg[2..0] D SCLR 3'h0 Q EX_MEM_MEM_TYPE~[2..0] 01 CLK

ID_EX_SRB[31..0] ID_EX_PC[31..0] ID_EX_ALU_OP[3..0] ID_EX_MEM_WRITE ID_EX_ALU_B_SRC ID_EX_SHAMT[4..0] ID_EX_PC_INC[31..0] ID_EX_IMM32[31..0] ID_EX_EX_OUT_SEL[1..0] ID_EX_RD[4..0] ID_EX_REG_WRITE LWCP_STALL | A_IN[31..0] 01 | EX_MEM_EXECUTE_OUT[0]~reg[31..0] D EX_MEM_EXECUTE_OUT~[63..32] 0 32'h0 1 SCLR 32'h0 CLK Q EX_MEM_EXECUTE_OUT~[31..0] 01 EX_MEM_MEM_WRITE~reg0 D EX_MEM_MEM_WRITE~1 0 1'h0 1 EX_MEM_PC[0]~reg[31..0] D SCLR 1'h0 CLK Q EX_MEM_MEM_WRITE~0 01

EX_MEM_WB_SRC_SEL~1 0 1'h0 1 =Equal0 SCLR 1'h0 Q EX_MEM_WB_SRC_SEL~0 01 EX_MEM_RD~[9..5] 0 5'h0 1 EX_MEM_REG_WRITE~reg0 D SCLR 5'h0 CLK Q EX_MEM_RD~[4..0] 01

EX_MEM_REG_WRITE~1 0 1'h0 1 EX_MEM_RS2[0]~reg[4..0] D SCLR 1'h0 Q EX_MEM_REG_WRITE~0 01 CLK
