acheng21567/RISCV-CPU-with-Image-Coproc-FPGA/Design_Diagrams/Synthesis/cpu_top.pdf

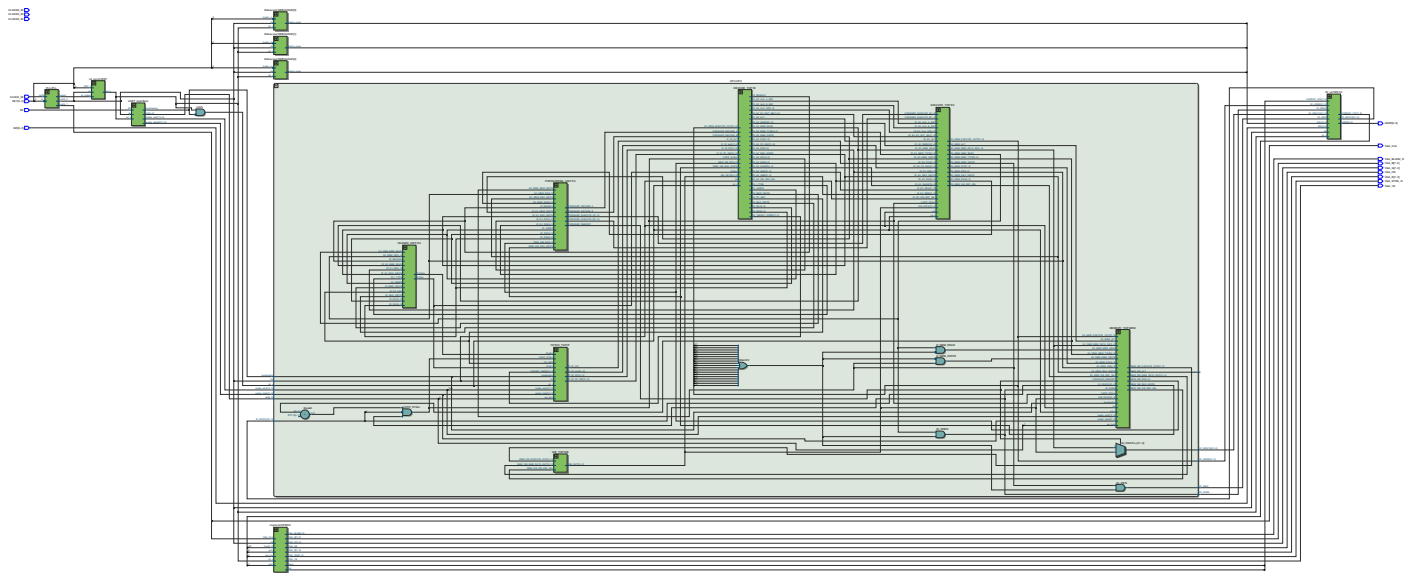
[picture p75: page 1]
CPU:CPU; bootloading; clk; rst_n; IO_RDATA[31..0]; wdata_data[31..0] wdata_addr[13..0] dst[2..0]; IO_RDEN; IO_WEN; IO_WDATA[31..0]; IO_ADDR[31..0]; CLOCK2_50 CLOCK3_50 CLOCK4_50; rst_synch:iRST; RST_n; clk pll_locked; DECODE_TOP:ID; FORWARD_DECODE_A; FORWARD_DECODE_B; IF_ID_HLT; LWCP_STALL MEM_WB_REG_WRITE; STALL; IF_ID_Inst[31..0]; WB_DATA[31..0]; IF_ID_PC_INC[31..0] MEM_WB_RD[4..0]; EX_MEM_EXECUTE_OUT[31..0]; ID_BRANCH; ID_EX_ALU_A_SRC; ID_EX_ALU_B_SRC; ID_EX_HLT; ID_EX_MEM_READ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

rst_n
