acheng21567/RISCV-CPU-with-Image-Coproc-FPGA/Design_Diagrams/Synthesis/d-mem_top.pdf

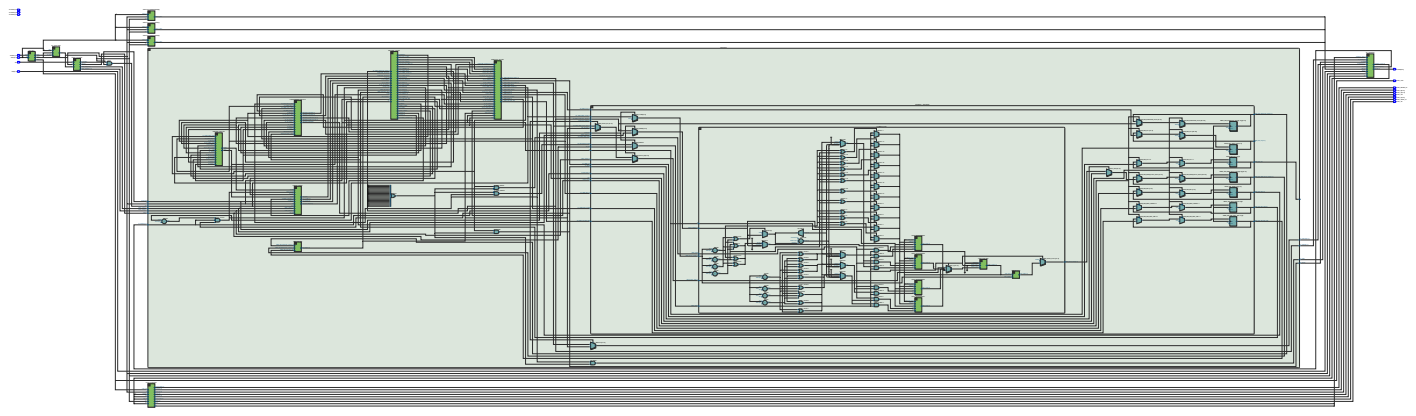
[picture p76: page 1]
CPU:CPU; bootloading; clk; rst_n; IO_RDATA[31..0]; wdata_data[31..0] wdata_addr[13..0] dst[2..0]; IO_RDEN; IO_WEN; IO_WDATA[31..0]; IO_ADDR[31..0]; MEMORY_TOP:MEM; EX_MEM_HLT; EX_MEM_REG_WRITE; EX_MEM_WB_SRC_SEL; LWCP_STALL; we_boot; EX_MEM_RD[4..0]; EX_MEM_PC[31..0]; wdata_data[31..0]; MEM_WB_REG_WRITE MEM_WB_WB_SRC_SEL; MEM_WB_MEM_DATA_OUT[31..0]; MEM_WB_EXECUTE_OUT[31..0]; MEM_WB_RD[4..0]; MEM_READ; MEM_WRITE; MEM_DATA_IN[31..0]; MEM_ADDR[12..0]; MEM_DATA_TYPE[2..0]; MEM_DATA_OUT[31..0]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

EX_MEM_MEM_TYPE[2..0] EX_MEM_EXECUTE_OUT[31..0] EX_MEM_MEM_DATA_IN[31..0] FORWARD_MEMORY WB_DATA[31..0] wdata_addr[12..0] bootloading EX_MEM_MEM_WRITE EX_MEM_MEM_READ | MEM_DATA_IN~[31..0] 01 | MEM_ADDR[12..0] 01 MEM_WRITE 01 | D_MEM:d_mem Selector0 address~13 01 address~14 address~15 01 address~16 address~17 01 address~18 address~19 01 address~20 address~3 01 address~4 address~5 01 address~6 clk address~7 01 address~8 rden wen | MEM_WB_PC~[31..0] 01 | MEM_WB_PC~[63..32] 0 32'h0 1 | MEM_WB_PC[31..0] MEM_WB_HLT

IO_RDEN
