acheng21567/RISCV-CPU-with-Image-Coproc-FPGA/Design_Diagrams/Synthesis/dma_top.pdf

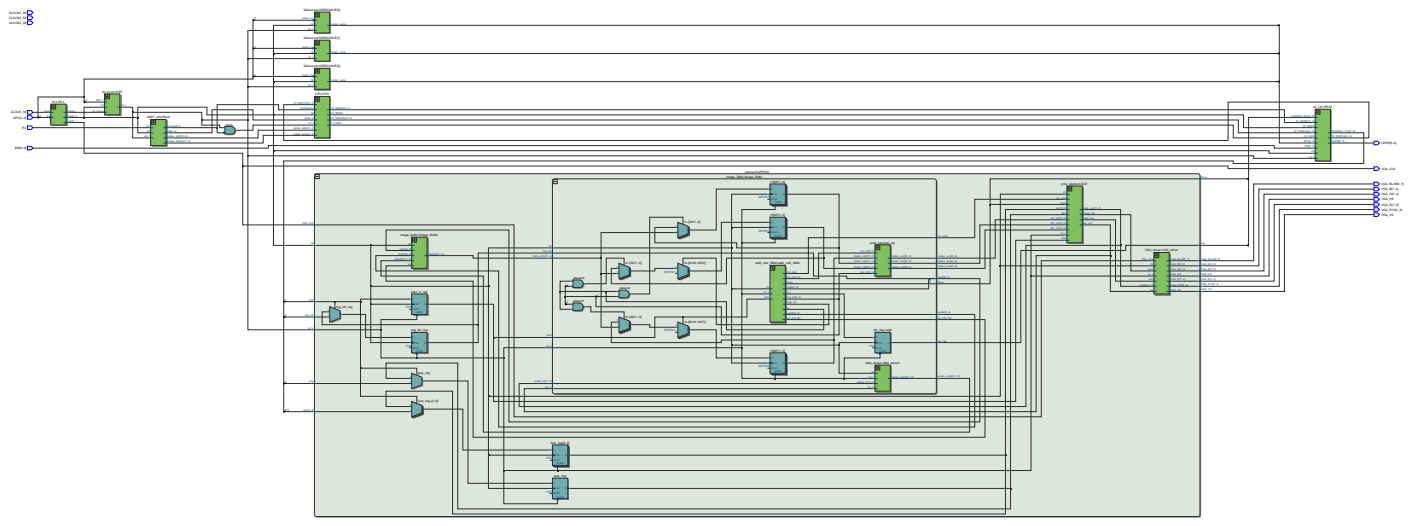
[picture p77: page 1]
coproc:iCOPROC; clk; gray; img_idx; rst_n; start; func[2..0]; VGA_BLANK_N; VGA_HS; VGA_SYNC_N; VGA_VS; done; rdy; VGA_B[7..0] VGA_G[7..0] VGA_R[7..0]; we_in wdata_in[11..0]; rdata_in[3071..0]; cnt_start; rdy_reg; we_img_buf; raddr[8..0]; waddr[8..0]; wdata_out[3071..0]; rdata0_out[35..0] rdata1_out[35..0] rdata2_out[35..0]; CLOCK3_50 CLOCK4_50; CPU:CPU; bootloading; IO_RDATA[31..0]; wdata_data[31..0] wdata_addr[13..0]; dst[2..0]; IO_RDEN; IO_WEN; IO_WDATA[31..0]; IO_ADDR[31..0]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

VGA_CLK | image_DMA:iImage_DMA r1[3071..0] D SCLR 3072'h0 CLKCLRN Q r2[3071..0] D clk start SCLR 1'h0 CLKCLRN Q data_accum:data_accum clk rst_n we_in wdata_in[11..0] wdata_out[3071..0]

raddr[8..0] waddr[8..0] wdata[3071..0]

start we wdata[11..0]
