acheng21567/RISCV-CPU-with-Image-Coproc-FPGA/Design_Diagrams/Synthesis/forwarding_logic.pdf

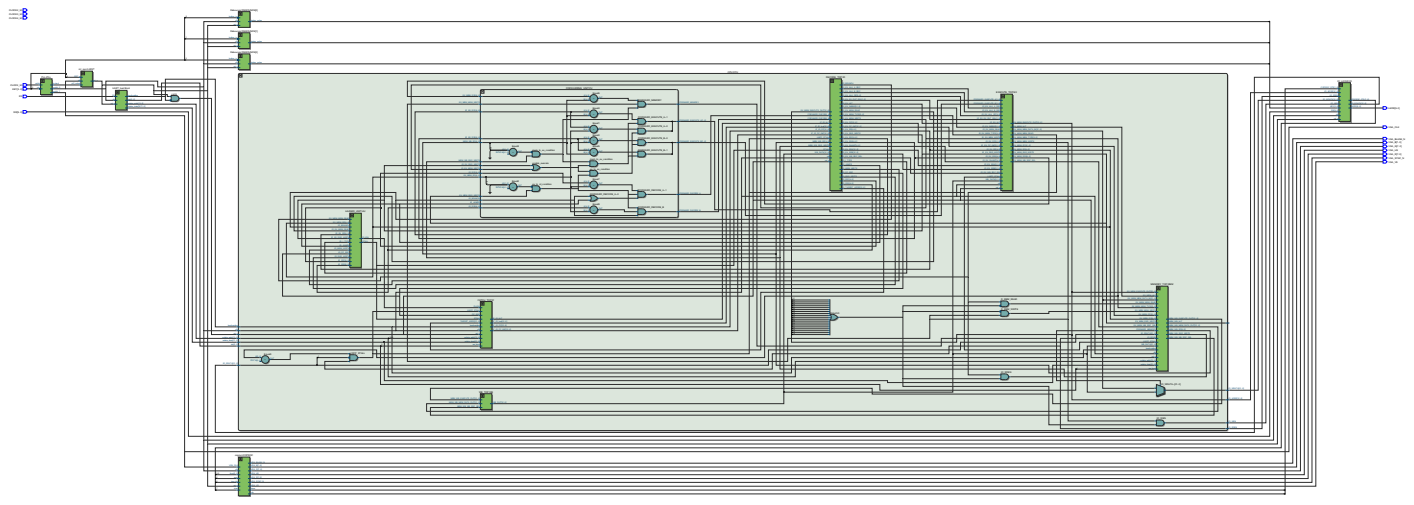
[picture p78: page 1]
CPU:CPU; bootloading; IO_RDATA[31..0]; IO_RDEN; IO_WEN; IO_WDATA[31..0]; IO_ADDR[31..0]; FORWARDING_UNIT:FU; EX_MEM_MEM_WRITE; ID_EX_MEM_WRITE; ID_EX_REG_WRITE; MEM_WB_REG_WRITE; EX_MEM_RS2[4..0]; MEM_WB_RD[4..0]; FORWARD_DECODE_A; FORWARD_DECODE_B; FORWARD_MEMORY; FORWARD_EXECUTE_A[1..0]; FORWARD_EXECUTE_B[1..0]; CLOCK3_50 CLOCK4_50; rst_synch:iRST; RST_n; clk pll_locked; rst_n; DECODE_TOP:ID; IF_ID_HLT; LWCP_STALL MEM_WB_REG_WRITE; STALL; clk; IF_ID_Inst[31..0]; WB_DATA[31..0]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

EX_MEM_RD[4..0] EX_MEM_REG_WRITE ID_BRANCH ID_JUMPR ID_RS2[4..0]

wdata_data[31..0] wdata_addr[13..0] dst[2..0] | clk rst_n | FETCH_TOP:IF FLUSH LWCP_STALL PC_SRC STALL IF_ID_HLT bootloading clk wdata_data[31..0] wdata_addr[10..0] rst_n we_boot | 30 31 26 27 28 29 22 23 24 25 18 19 20 21 14 15 16 17

D_MEM_READ D_MEM_WRITE
