acheng21567/RISCV-CPU-with-Image-Coproc-FPGA/DEMO/img_buf512x640.sv

// /////////////////////////////////////////////////////////////////////////////
// Program: img_buf512x640.sv
// 
// Project: ECE 554 COPROC
// 
// Author: Team Sachima
// 
// Description:
//  - Image buffer that stores 512x640 pixels for image processing
// 
//  - Inputs:
//     clk: 	          Global clock signal for 25MHz
//     we: 	            Write enable for writing to specified waddr
//     waddr [8:0]: 	  9-bit write address for the image buffer 
//     raddr [8:0]: 	  9-bit Read address for the image buffer
//     wdata [639:0]: 	640-bit write data to be written in to the address specified by waddr
// 
//  - Outputs:
//     rdata [639:0]: 	640-bit read data reading out from the address specified by raddr
// /////////////////////////////////////////////////////////////////////////////

module img_buf512x640 (clk,we,waddr,raddr,rdata,wdata);
  
  input clk,we;
  input [8:0] waddr,raddr;
  input [639:0] wdata;
  output reg [639:0] rdata;

  reg [639:0]mem10k[0:511];
  
  always @(posedge clk) begin
    if (we)
      mem10k[waddr] <= wdata;
    rdata <= mem10k[raddr];
  end

endmodule
    
    
  
